sleeperov/shmel-ok/docs/user.md

# Hall of fame

This page contains user-built drones based on the Flix project. Publish your projects into the official Telegram-chat: [@opensourcequadcopterchat](https://t.me/opensourcequadcopterchat) or send materials as a pull request.

---

Author: [@fisheyeu](https://t.me/fisheyeu).<br>
[Video](https://drive.google.com/file/d/1IT4eMmWPZpmaZR_qsIRmNJ52hYkFB_0q/view?usp=share_link).

<table>
	<tr>
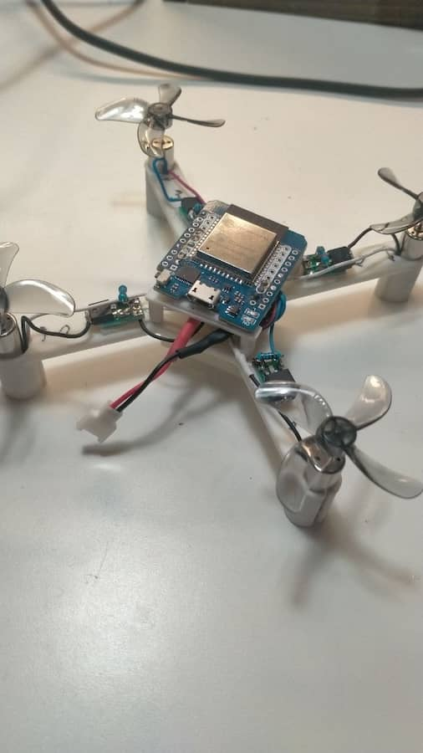
[picture p5: docs/img/user/fisheyeu/1.jpg]
		<td></td>
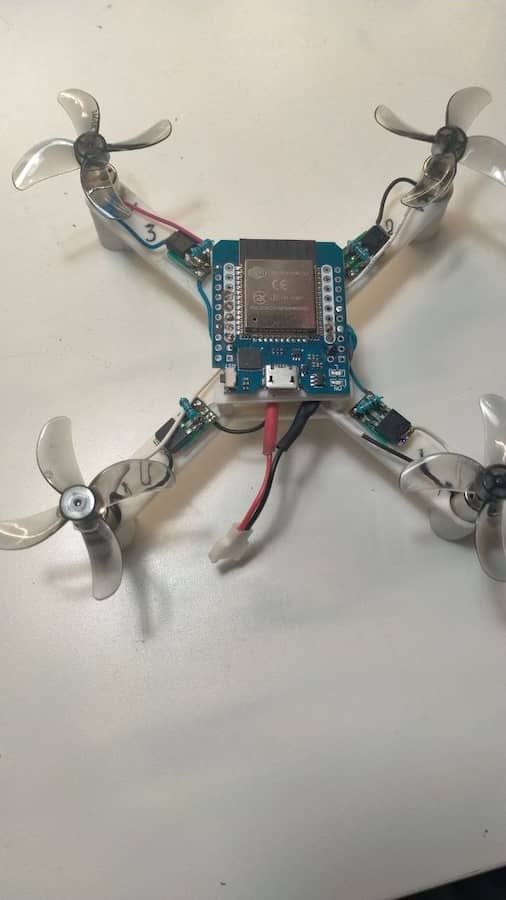
[picture p6: docs/img/user/fisheyeu/2.jpg]
		<td></td>
	</tr>
</table>

---

Author: [@p_kabakov](https://t.me/p_kabakov).<br>
Custom propellers guard 3D-model: https://drive.google.com/file/d/1TKnzwvrZYzYuRTLLERNmnKH71H9n4Xj_/view?usp=share_link.<br>
Features: ESP32-C3 microcontroller is used.<br>
[Video](https://drive.google.com/file/d/1B0NMcsk0fgwUgNr9XuLOdR2yYCuaj008/view?usp=share_link).

<table>
	<tr>
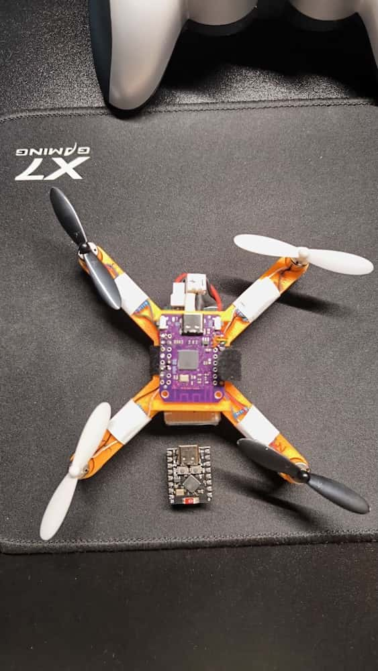
[picture p7: docs/img/user/p_kabakov/1.jpg]
		<td></td>
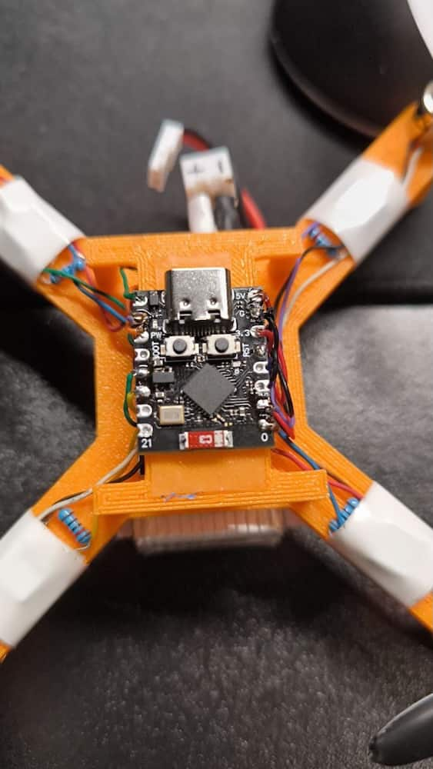
[picture p8: docs/img/user/p_kabakov/2.jpg]
		<td></td>
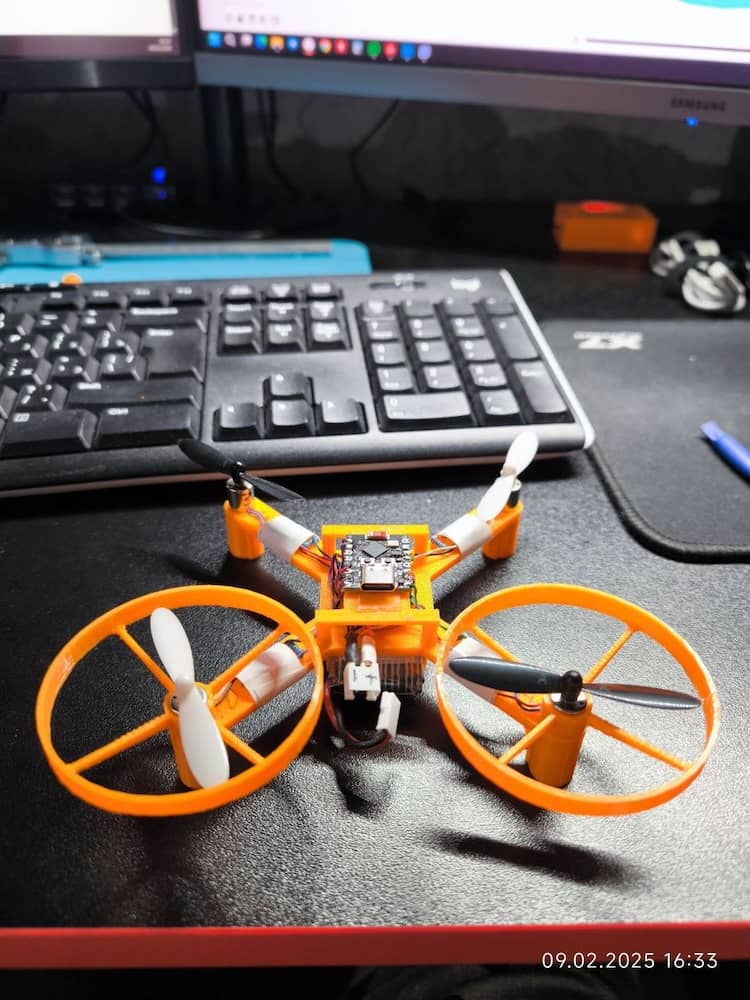
[picture p9: docs/img/user/p_kabakov/3.jpg]
		<td></td>
	</tr>
</table>

---

Author: [@yi_lun](https://t.me/yi_lun).<br>
[Video](https://drive.google.com/file/d/1TkSuvHQ_0qQPFUpY5XjJzmhnpX_07cTg/view?usp=share_link).

<table>
	<tr>
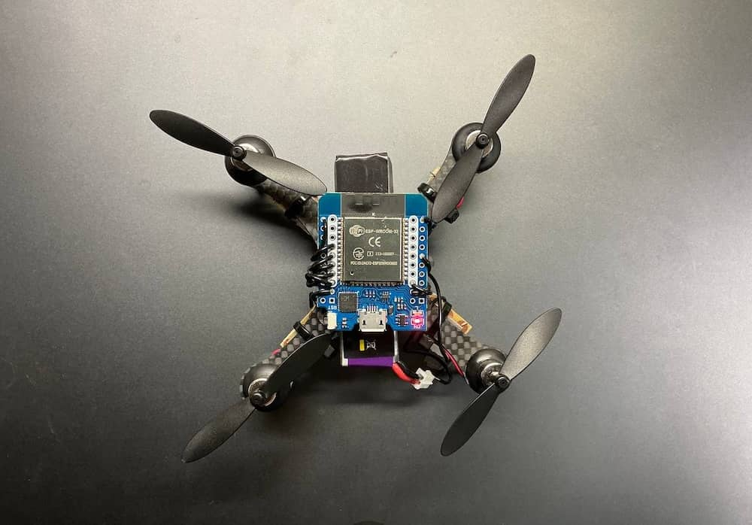
[picture p10: docs/img/user/yi_lun/1.jpg]
		<td></td>
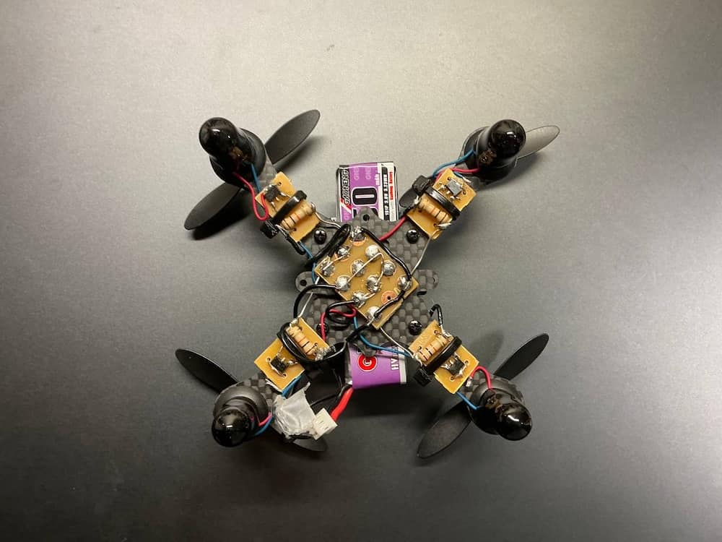
[picture p11: docs/img/user/yi_lun/2.jpg]
		<td></td>
	</tr>
</table>

---

Author: [@peter_ukhov](https://t.me/peter_ukhov).<br>
Features: customized ESP32 holder, GY-ICM20948V2 IMU board, boost-converter for powering the ESP32.<br>
Files for 3D-printing: https://drive.google.com/file/d/1Sma-FEzFBj2HA5ixJtUyH0uWixvr6vdK/view?usp=share_link.<br>
Schematics: https://miro.com/app/board/uXjVN-dTjoo=/?moveToWidget=3458764612179508274&cot=14.<br>

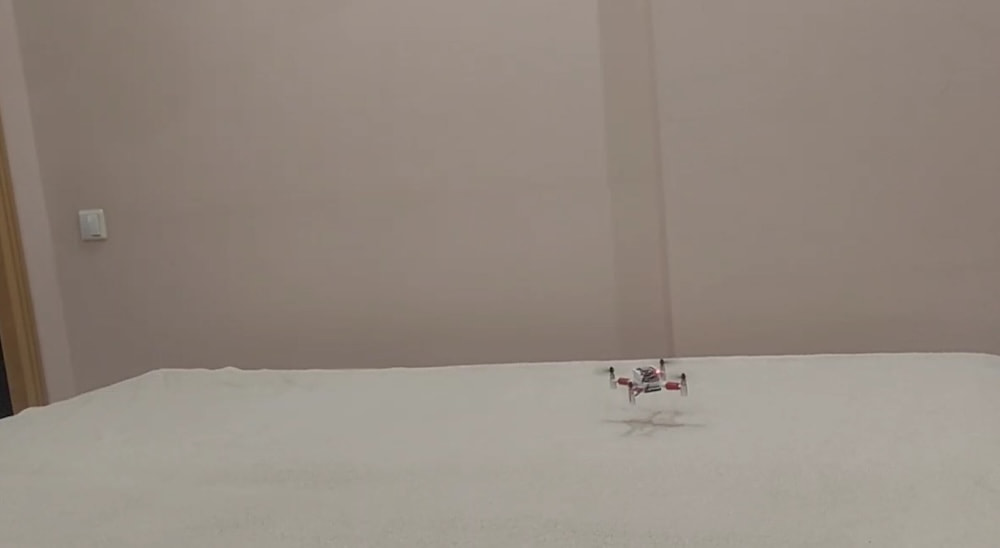
[picture p12: docs/img/user/peter_ukhov-2/video.jpg]


<table>
	<tr>
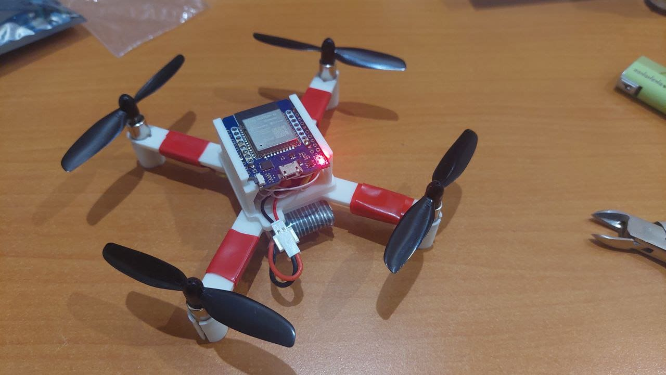
[picture p13: docs/img/user/peter_ukhov-2/1.jpg]
		<td></td>
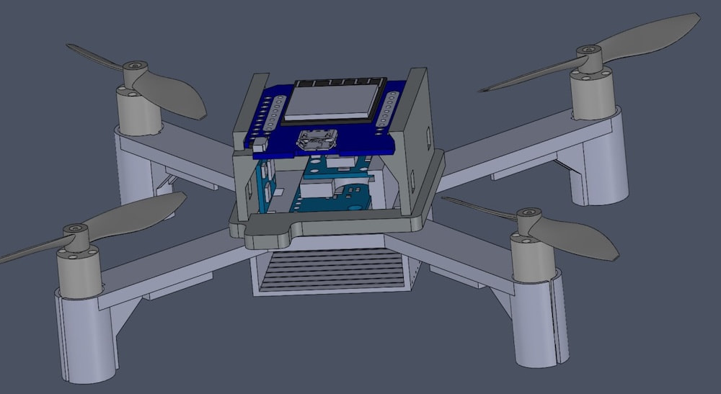
[picture p14: docs/img/user/peter_ukhov-2/2.jpg]
		<td></td>
	</tr>
</table>

---

Author: [@Alexey_Karakash](https://t.me/Alexey_Karakash).<br>
Files for 3D printing of the custom frame: https://drive.google.com/file/d/1tkNmujrHrKpTMVtsRH3mor2zdAM0JHum/view?usp=share_link.<br>

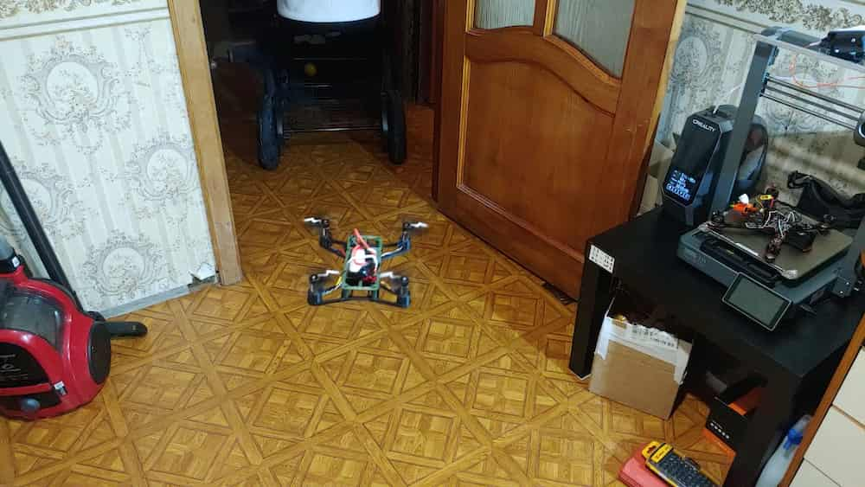
[picture p15: docs/img/user/alexey_karakash/video.jpg]


<table>
	<tr>
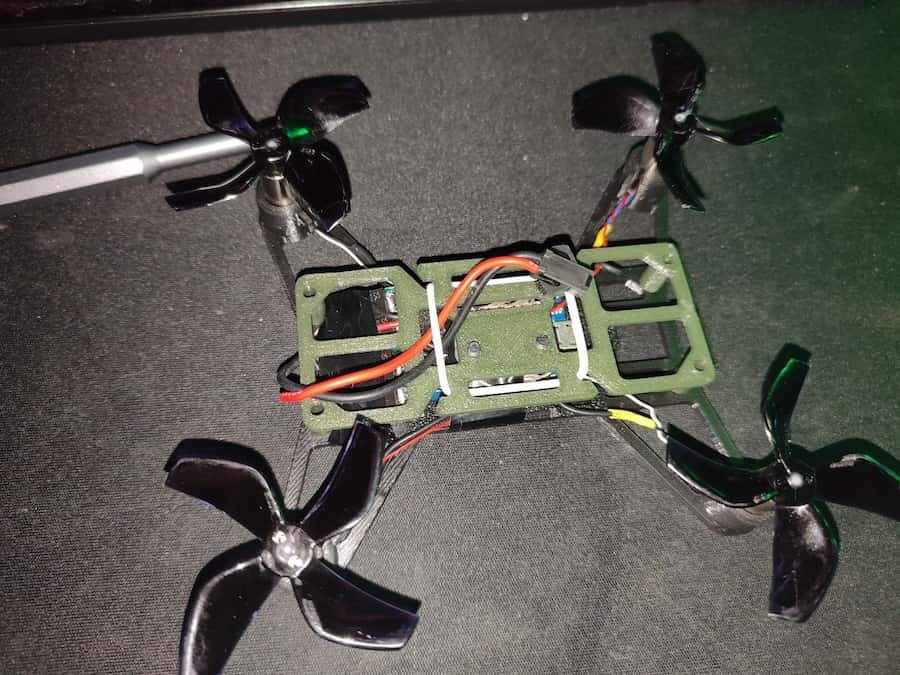
[picture p16: docs/img/user/alexey_karakash/1.jpg]
		<td></td>
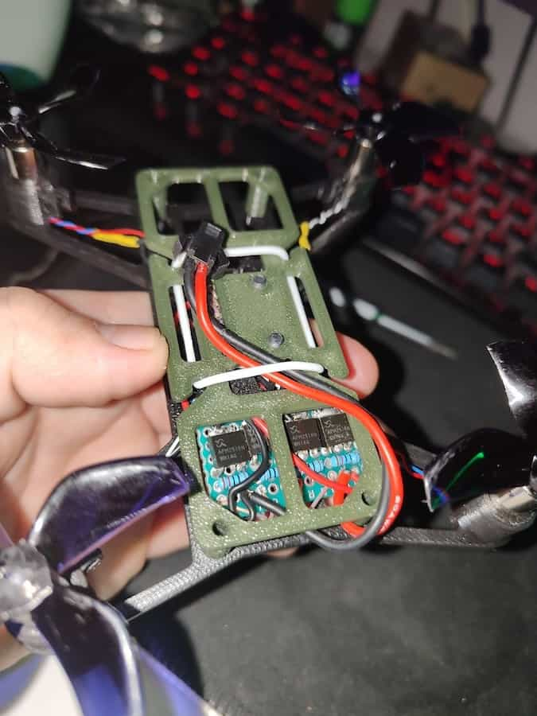
[picture p17: docs/img/user/alexey_karakash/2.jpg]
		<td></td>
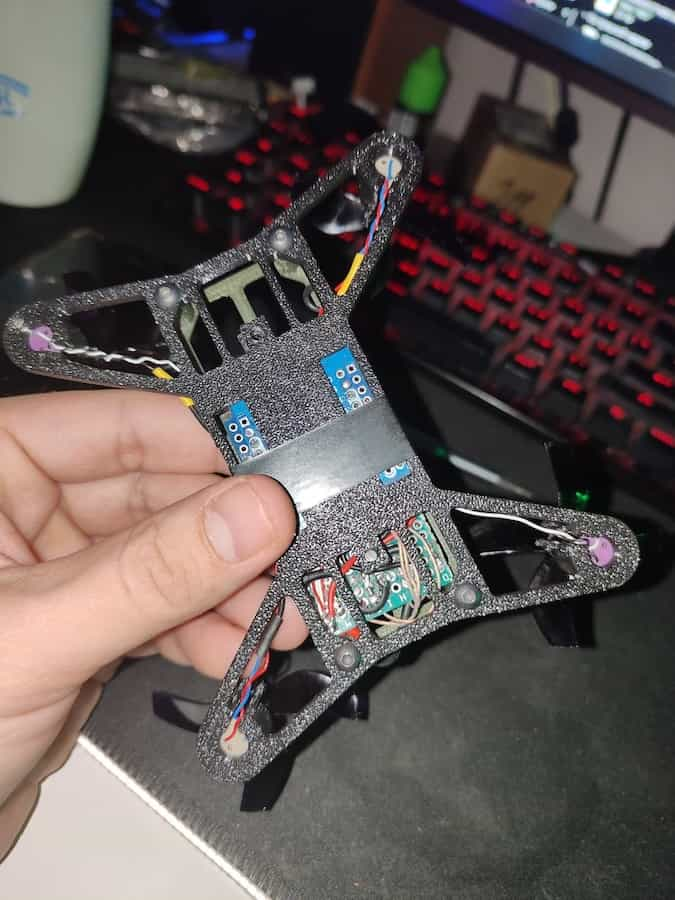
[picture p18: docs/img/user/alexey_karakash/3.jpg]
		<td></td>
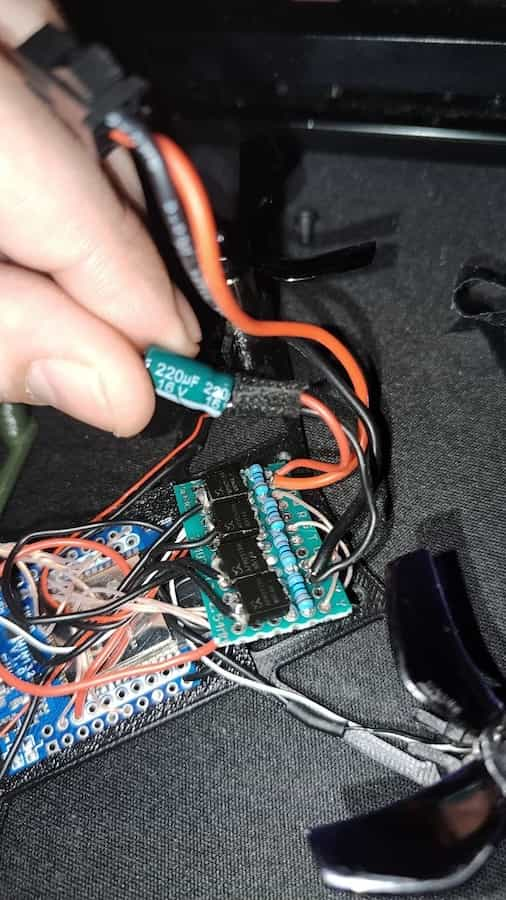
[picture p19: docs/img/user/alexey_karakash/4.jpg]
		<td></td>
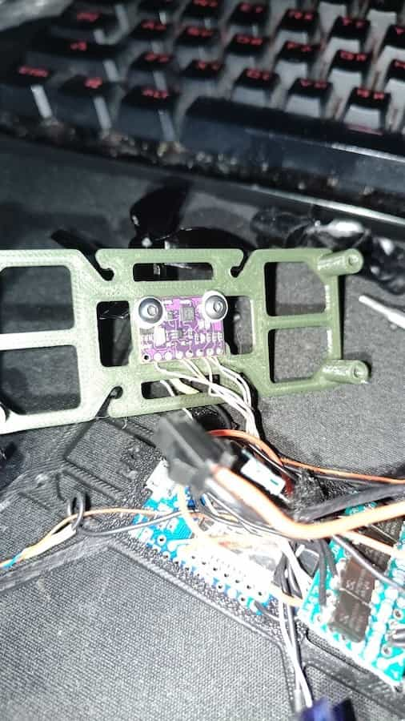
[picture p20: docs/img/user/alexey_karakash/5.jpg]
		<td></td>
	</tr>
</table>

---

Author: [@rudpa](https://t.me/rudpa).<br>

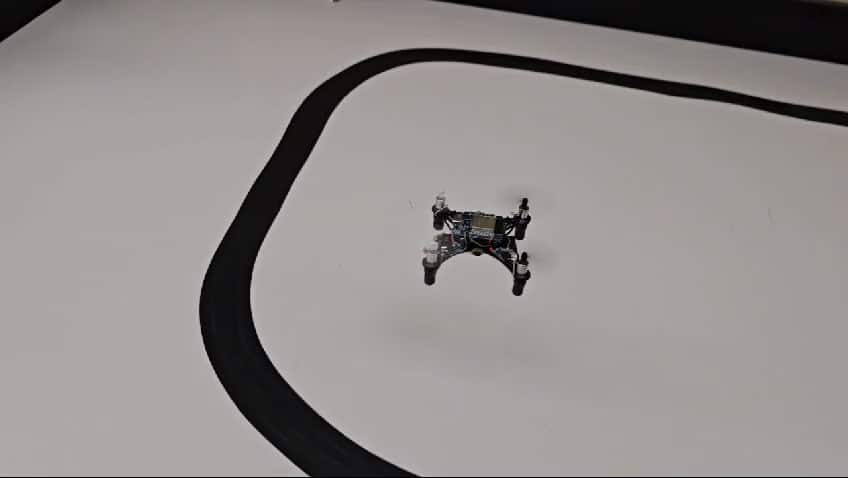
[picture p21: docs/img/user/rudpa/video.jpg]


<table>
	<tr>
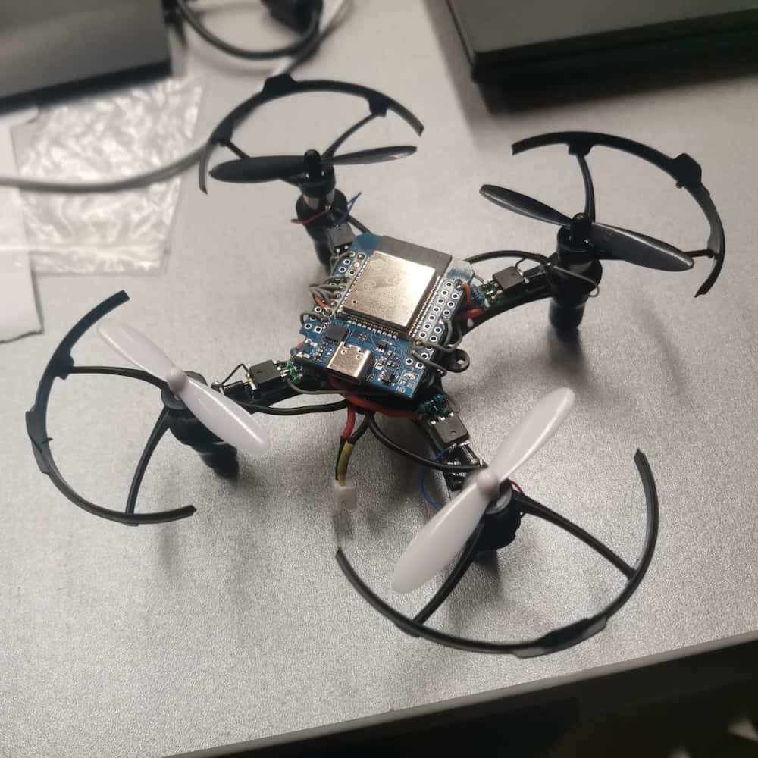
[picture p22: docs/img/user/rudpa/1.jpg]
		<td></td>
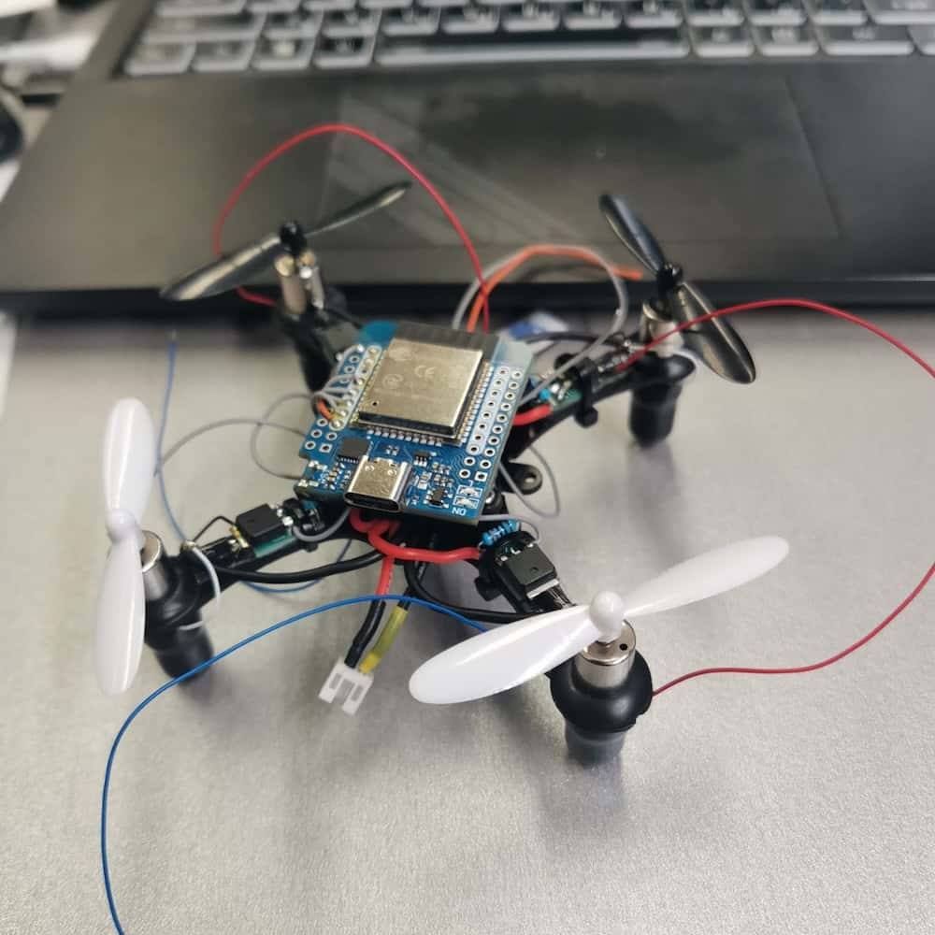
[picture p23: docs/img/user/rudpa/2.jpg]
		<td></td>
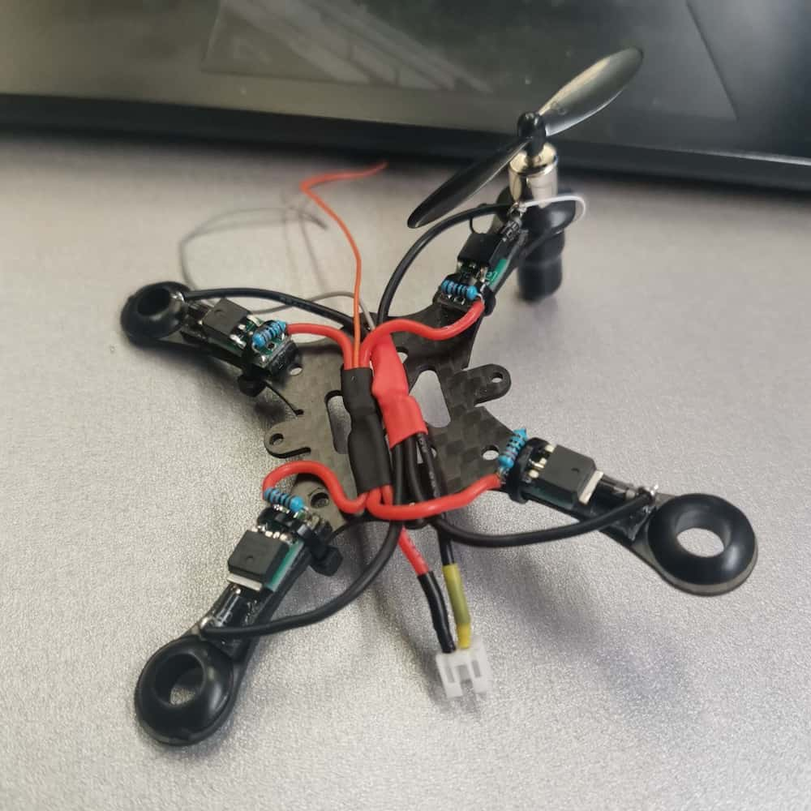
[picture p24: docs/img/user/rudpa/3.jpg]
		<td></td>
	</tr>
</table>

---

Author: [@peter_ukhov](https://t.me/peter_ukhov).<br>
Schematics: https://miro.com/app/board/uXjVN-dTjoo=/?moveToWidget=3458764612338222067&cot=14.<br>

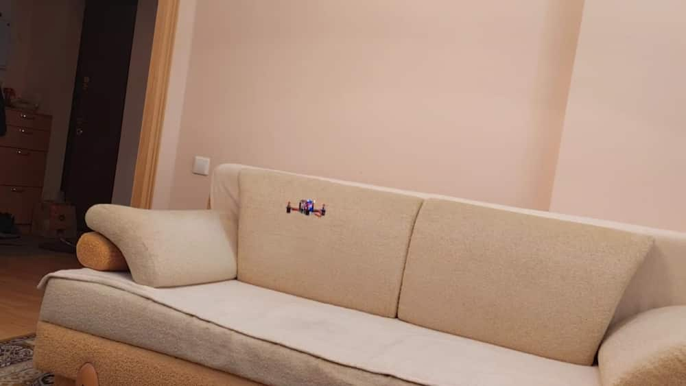
[picture p25: docs/img/user/peter_ukhov/video.jpg]


<table>
	<tr>
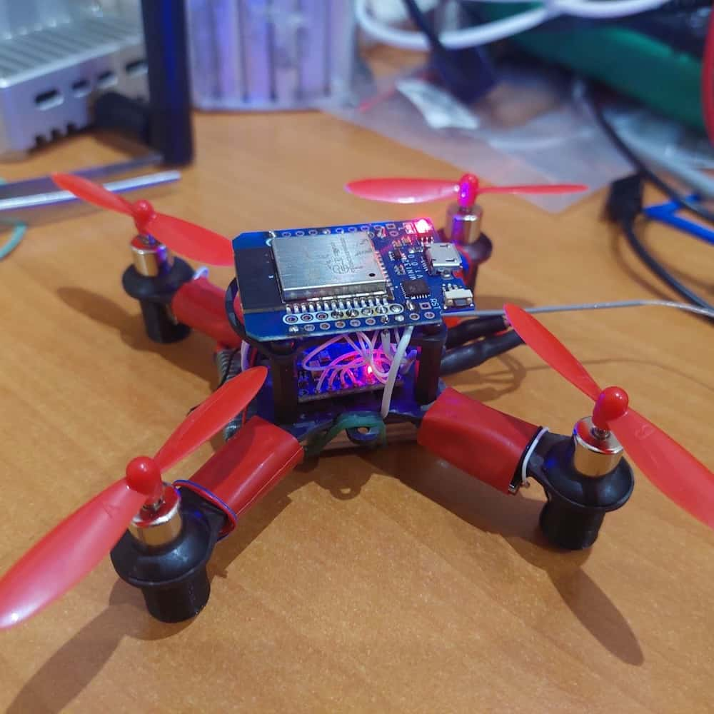
[picture p26: docs/img/user/peter_ukhov/1.jpg]
		<td></td>
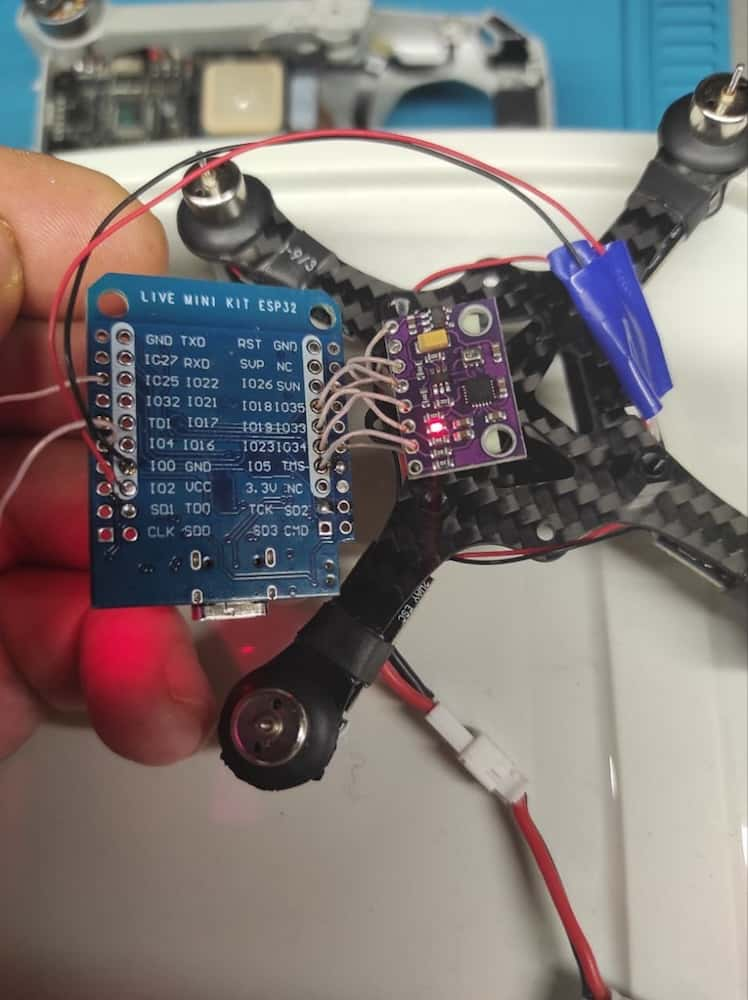
[picture p27: docs/img/user/peter_ukhov/2.jpg]
		<td></td>
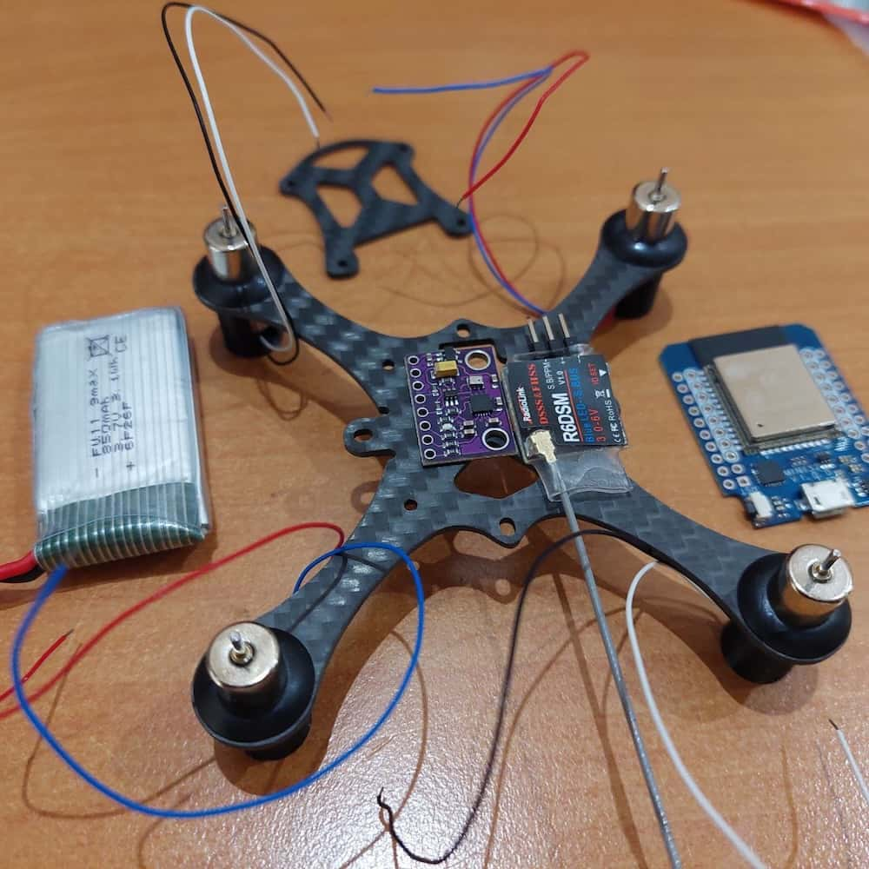
[picture p28: docs/img/user/peter_ukhov/3.jpg]
		<td></td>
	</tr>
</table>
