sleeperov/shmel-ok/docs/version0.md

# Flix version 0

Flix version 0 (obsolete):

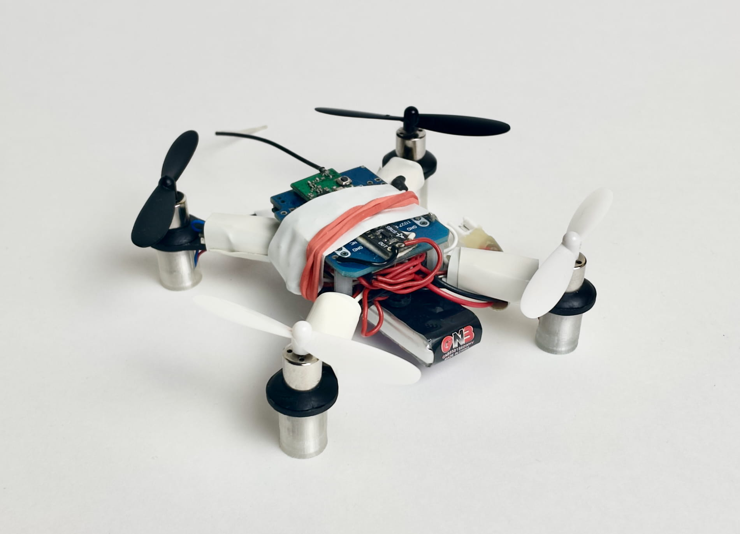
[picture p29: docs/img/flix.jpg]
Flix quadcopter


## Components list

|Type|Part|Image|Quantity|
|-|-|-|-|
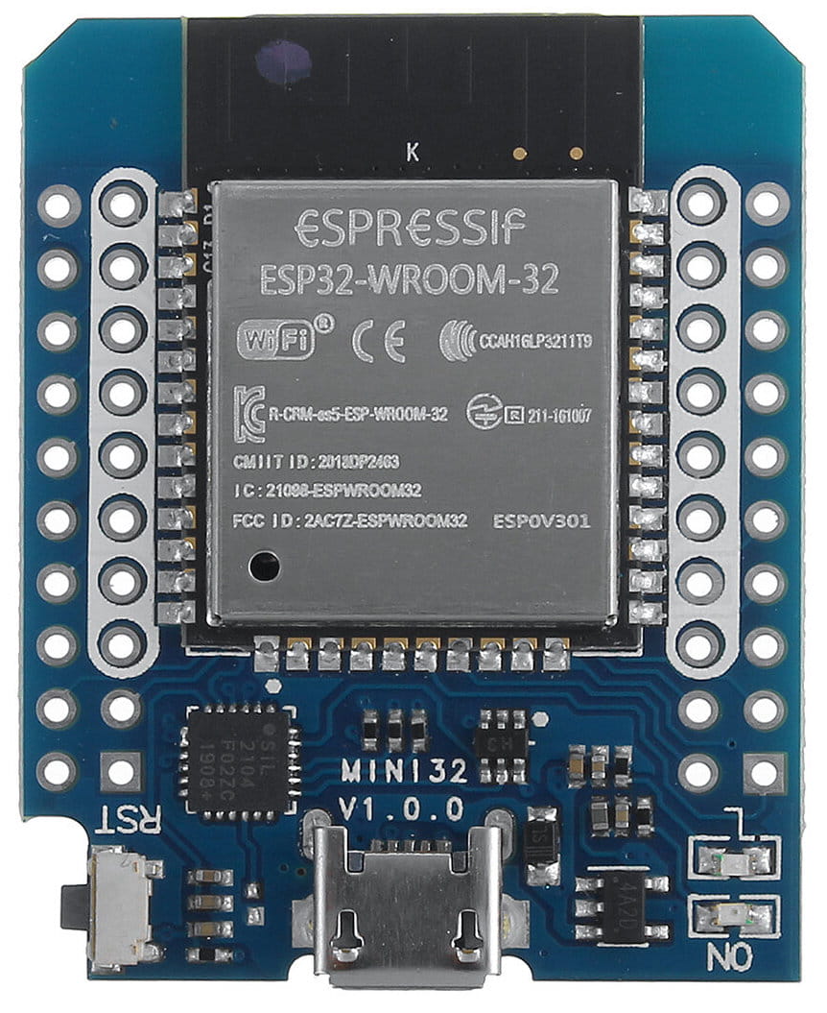
[picture p30: docs/img/esp32.jpg]
|Microcontroller board|ESP32 Mini||1|
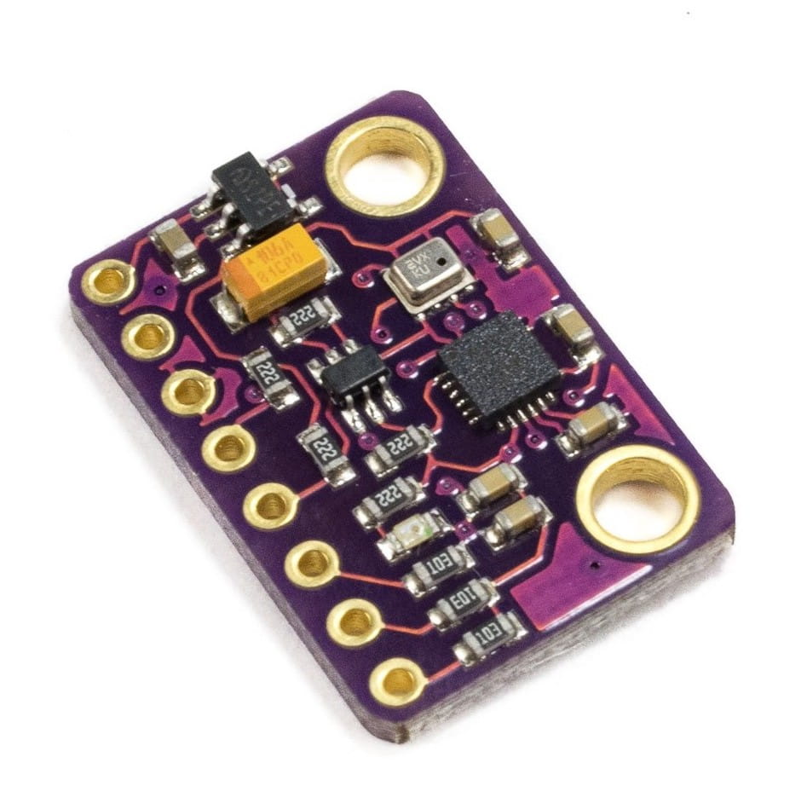
[picture p31: docs/img/gy-91.jpg]
|IMU and barometer² board|GY-91 (or other MPU-9250 board)||1|
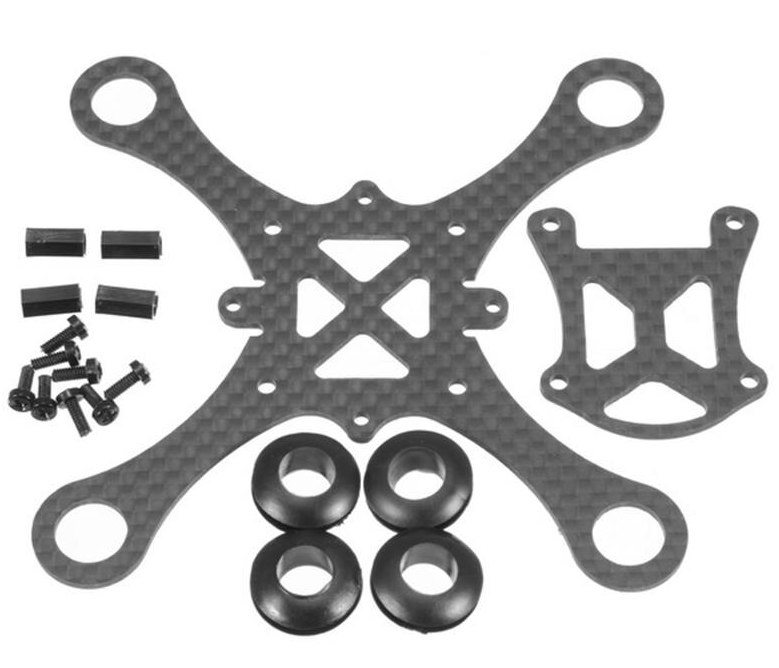
[picture p32: docs/img/frame.jpg]
|Quadcopter frame|K100||1|
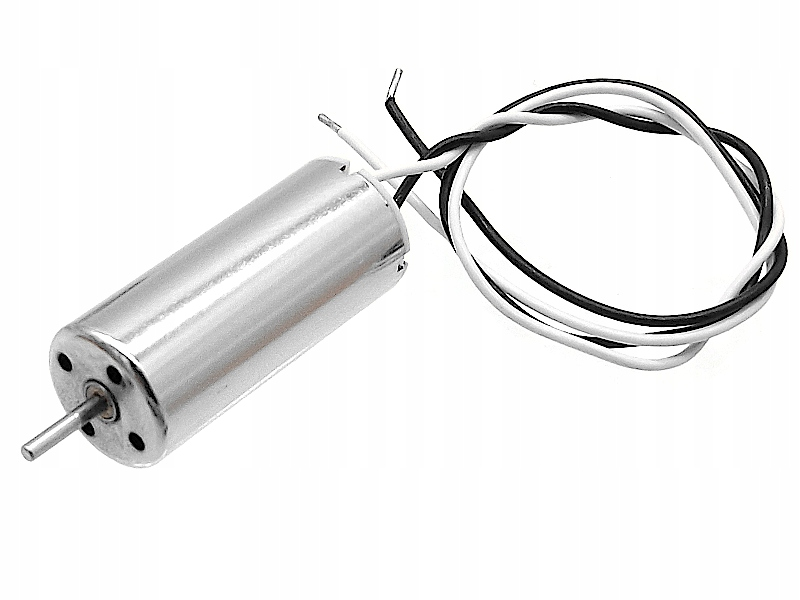
[picture p33: docs/img/motor.jpeg]
|Motor|8520 3.7V brushed motor (**shaft 0.8mm!**)||4|
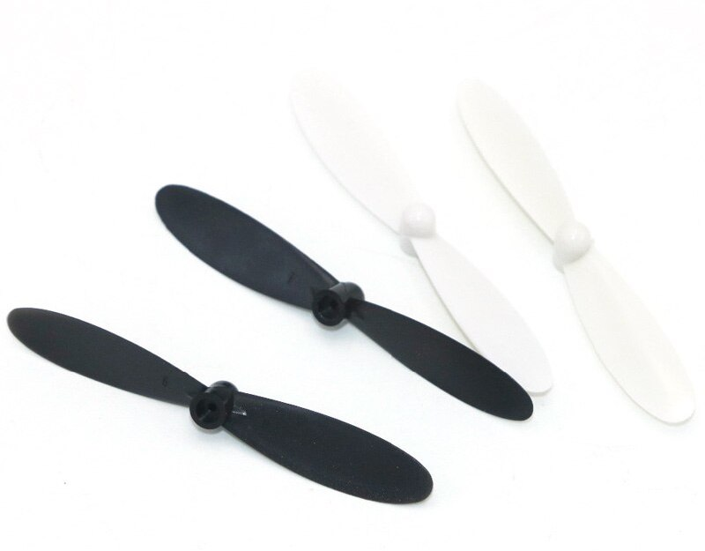
[picture p34: docs/img/prop.jpg]
|Propeller|Hubsan 55 mm||4|
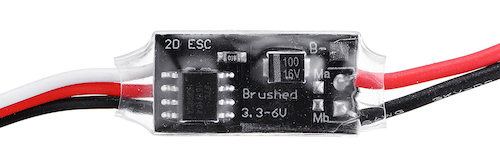
[picture p35: docs/img/esc.jpg]
|Motor ESC|2.7A 1S Dual Way Micro Brush ESC||4|
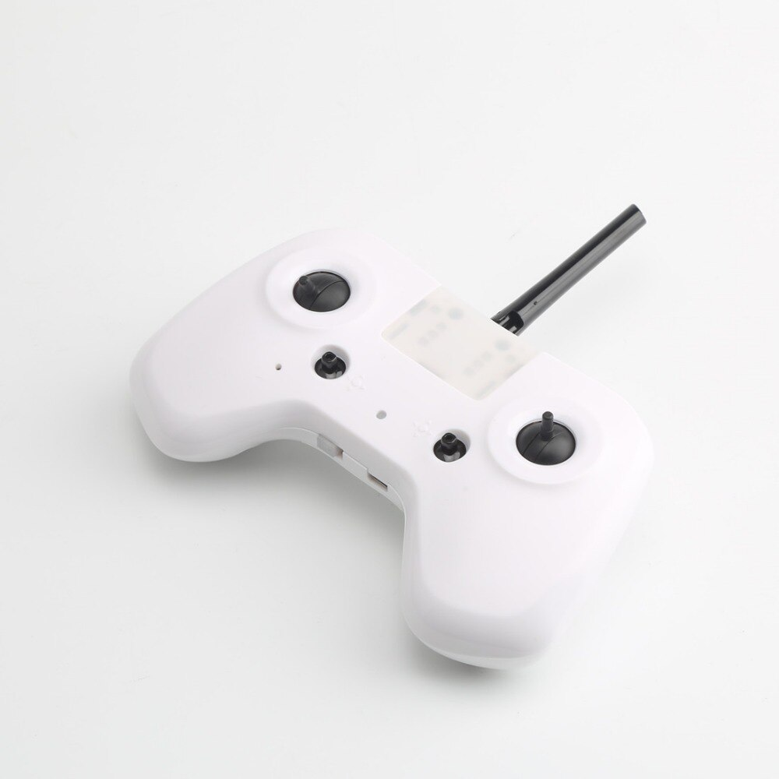
[picture p36: docs/img/tx.jpg]
|RC transmitter|KINGKONG TINY X8||1|
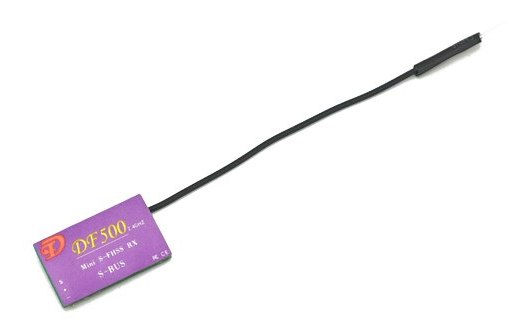
[picture p37: docs/img/rx.jpg]
|RC receiver|DF500 (SBUS)||1|
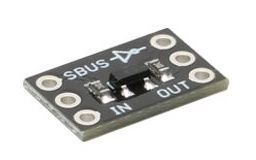
[picture p38: docs/img/inv.jpg]
|~~SBUS inverter~~*|||~~1~~|
|Battery|3.7 Li-Po 850 MaH 60C|||
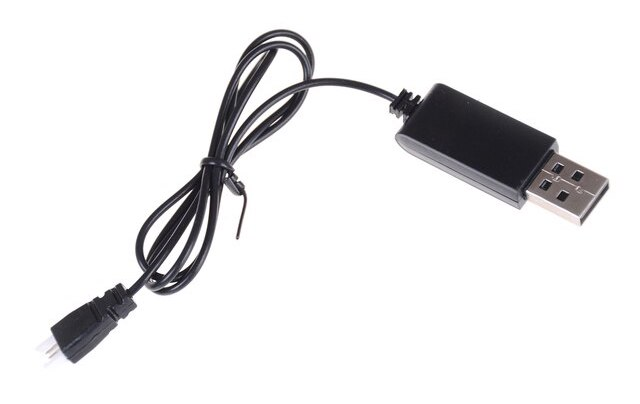
[picture p39: docs/img/charger.jpg]
|Battery charger|||1|
|Wires, connectors, tape, ...||||

*\* — not needed as ESP32 supports [software pin inversion](https://github.com/bolderflight/sbus#inverted-serial).*

## Schematics

Flix schematics

You can also check a user contributed [variant of complete circuit diagram](https://miro.com/app/board/uXjVN-dTjoo=/?moveToWidget=3458764574482511443&cot=14) of the drone.
