sleeperov/shmel-ok/docs/book/SUMMARY.md

<!-- markdownlint-disable MD041 -->
<!-- markdownlint-disable MD042 -->

[Главная](./README.md)

* [Архитектура прошивки](firmware.md)

# Учебник

* [Основы]()
* [Светодиод]()
* [Моторы]()
* [Радиоуправление]()
* [Гироскоп](gyro.md)
* [Акселерометр]()
* [Оценка состояния]()
* [PID-регулятор]()
* [Режим ACRO]()
* [Режим STAB]()
* [Wi-Fi]()
* [MAVLink]()
* [Симуляция]()
