sleeperov/shmel-ok/docs/book/README.md

# Flix

> [!IMPORTANT]
> Flix — это проект по созданию открытого квадрокоптера на базе ESP32 с нуля и учебника по разработке полетных контроллеров.

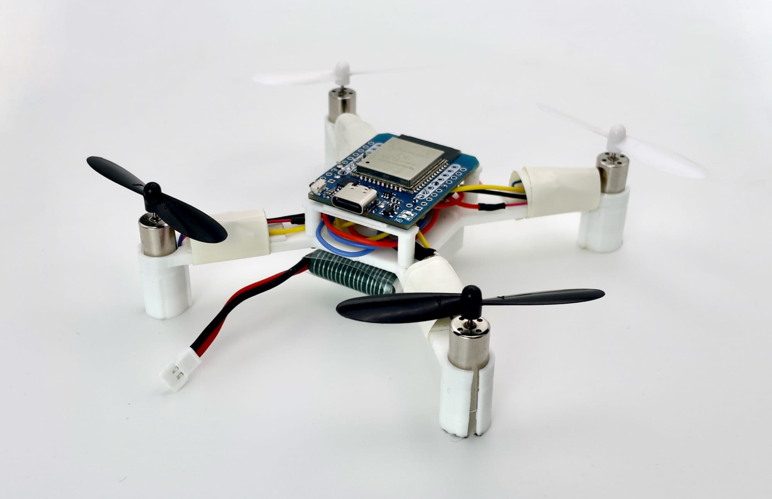
[picture p46: docs/img/flix1.jpg]
Flix quadcopter


<p class="github">GitHub:&nbsp;<a href="https://github.com/okalachev/flix">github.com/okalachev/flix</a>.</p>

<p class="telegram">Telegram-канал:&nbsp;<a href="https://t.me/opensourcequadcopter">@opensourcequadcopter</a>.</p>
