sleeperov/shmel-ok/gazebo/models/flix/flix.stl

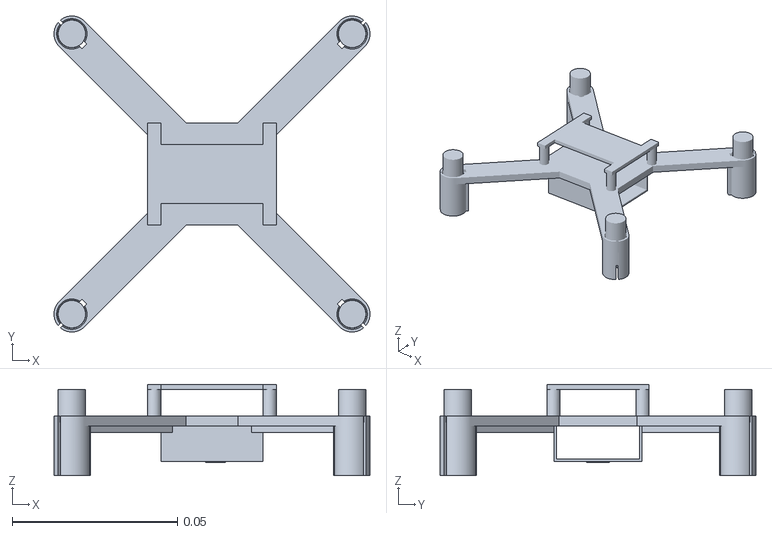
[picture p110: CAD file, 2025-02-17]
gazebo/models/flix/flix.stl
0.0957 x 0.0957 x 0.0276
