sleeperov/shmel-ok/shmel-ok-frame.stl

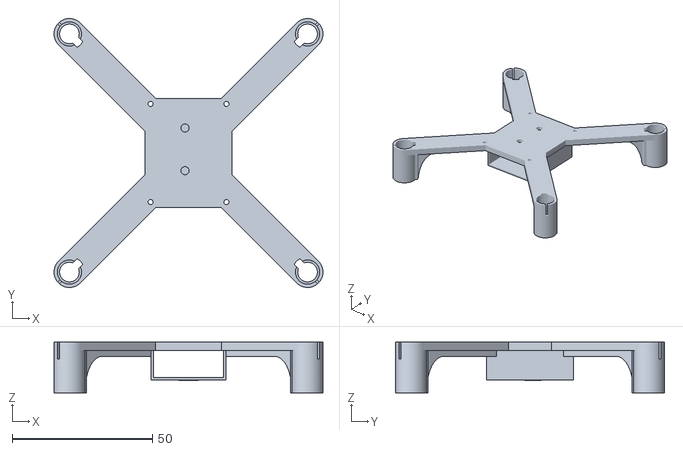
[picture p111: CAD file, 2025-02-17]
shmel-ok-frame.stl
95.9 x 95.9 x 18.0
