sleeperov/shmel-ok/docs/assets/esp32-holder.step

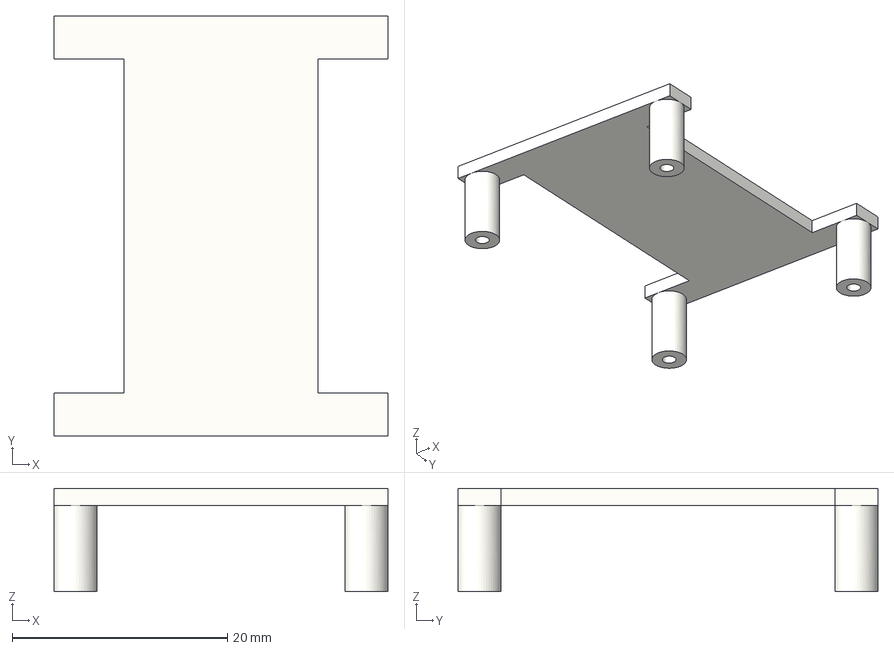
[picture p112: CAD file, 2025-02-17]
docs/assets/esp32-holder.step
31.0 x 39.0 x 9.60 mm
