sleeperov/shmel-ok/shmel-ok-GY-91.stl

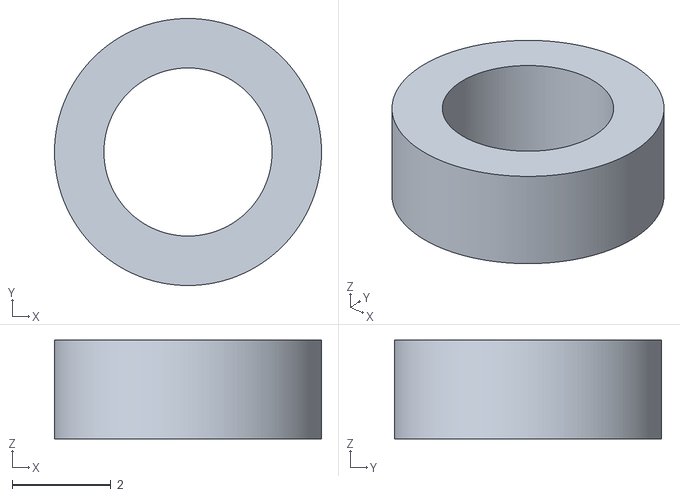
[picture p113: CAD file, 2025-02-17]
shmel-ok-GY-91.stl
5.40 x 5.40 x 2.00
