sleeperov/shmel-ok/(list of files, cad)

Other CAD files:
docs/assets/flix-frame.step
shmel-ok-esp32.stl
docs/assets/flix-frame-1.1.step
docs/assets/washer-m3.step
docs/assets/flix-frame.stl
