sleeperov/shmel-ok/docs/assembly.md

# Brief assembly guide

Soldered components ([schematics variant](https://miro.com/app/board/uXjVN-dTjoo=/?moveToWidget=3458764612338222067&cot=14)):

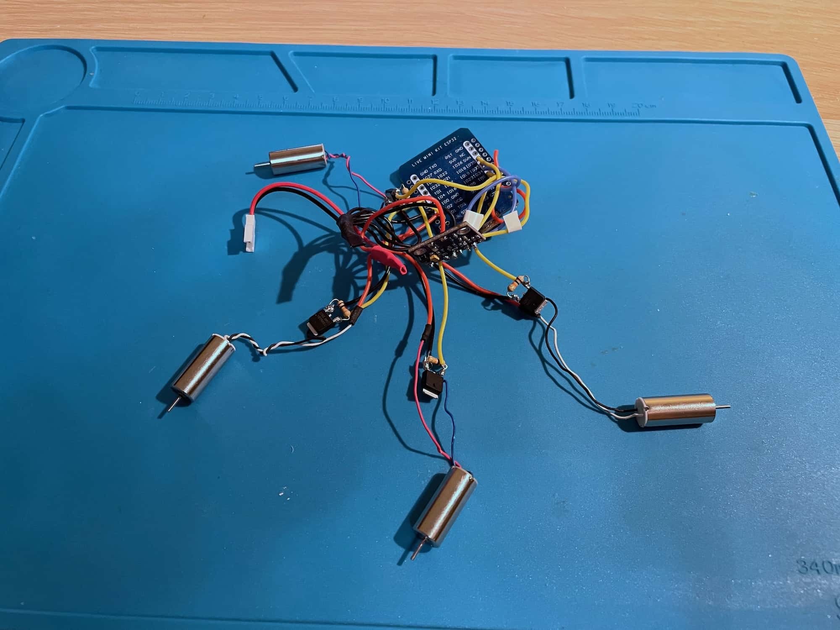
[picture p114: docs/img/assembly/1.jpg]


<br>Use double-sided tape to attach ESP32 to the top frame part (ESP32 holder):

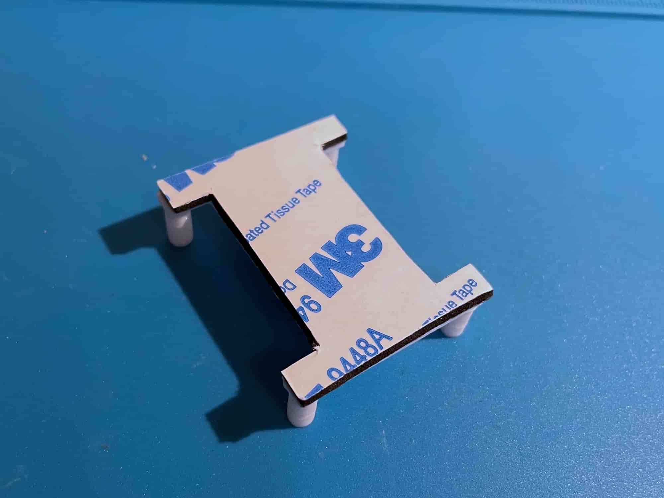
[picture p115: docs/img/assembly/2.jpg]


<br>Use two washers to screw the IMU board to the frame:

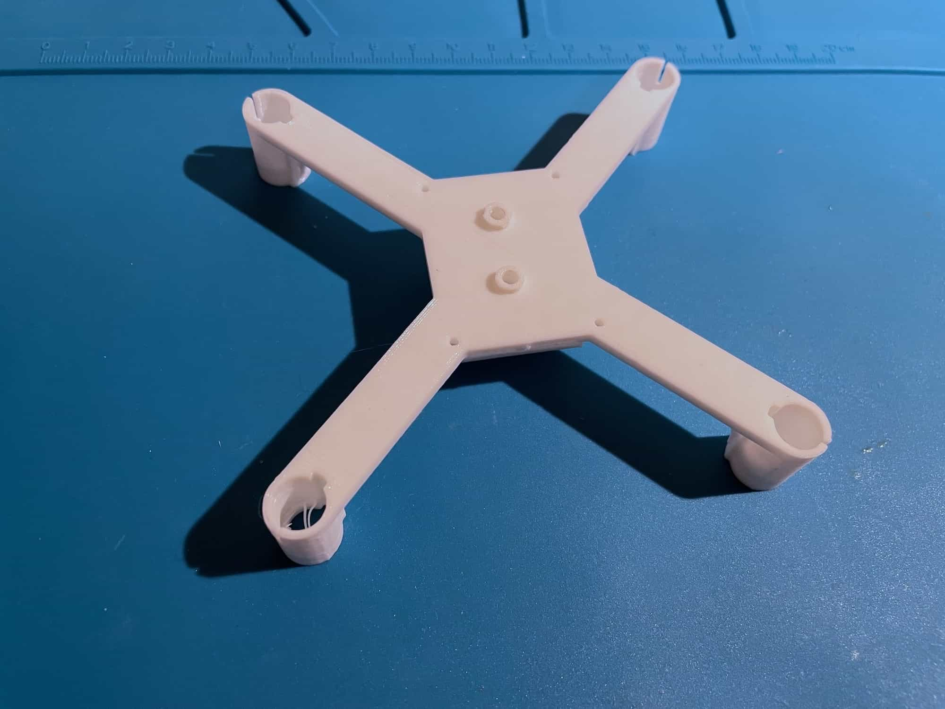
[picture p116: docs/img/assembly/3.jpg]


<br>Screw the IMU with M3x5 screws as shown:

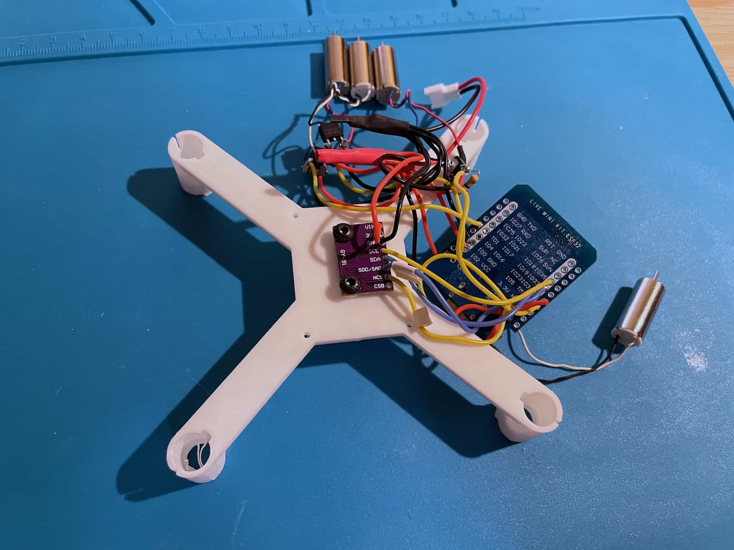
[picture p117: docs/img/assembly/4.jpg]


<br>Install the motors, attach MOSFETs to the frame using tape:

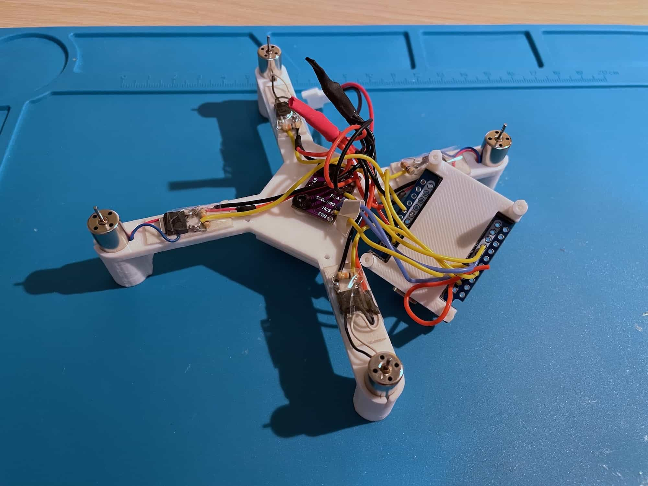
[picture p118: docs/img/assembly/5.jpg]


<br>Screw the ESP32 holder with M1.4x5 screws to the frame:

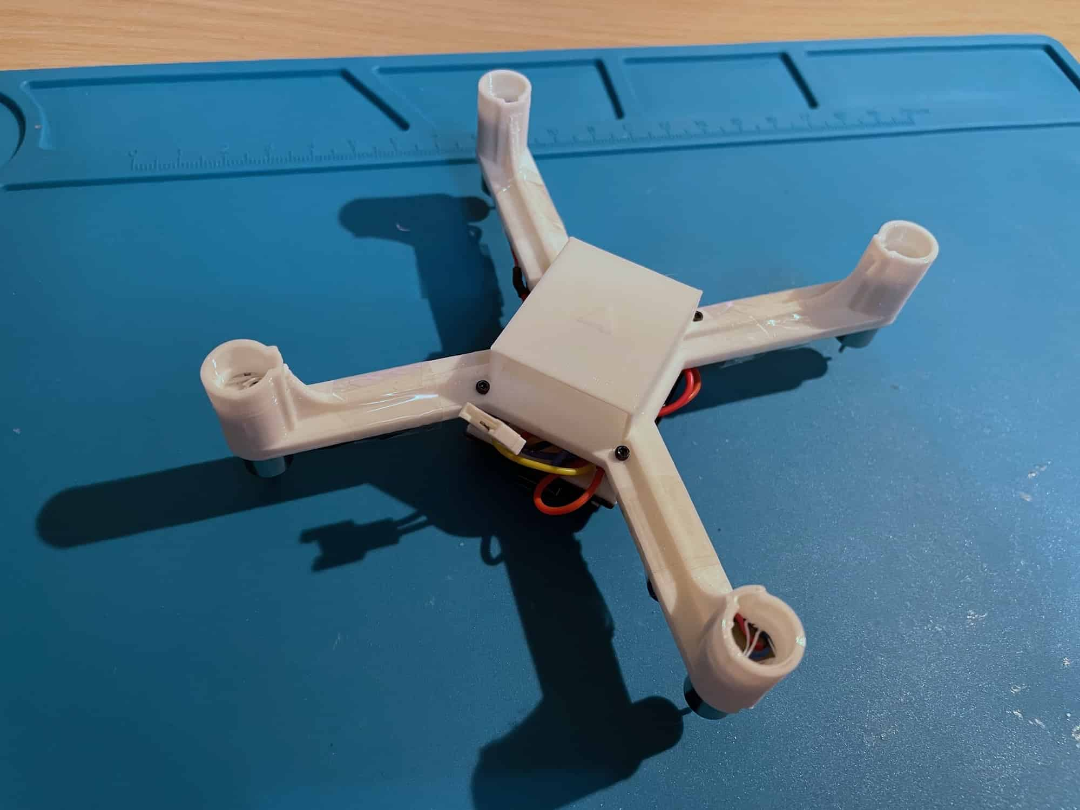
[picture p119: docs/img/assembly/6.jpg]


<br>Assembled drone:

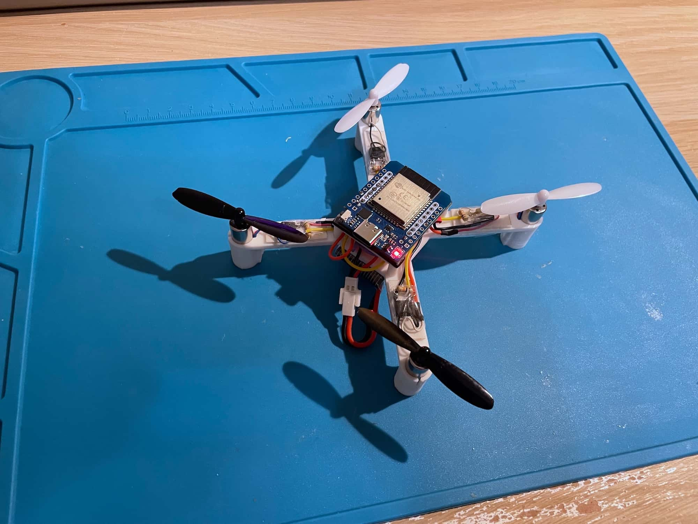
[picture p120: docs/img/assembly/7.jpg]
