sleeperov/shmel-ok/shmel-ok/motors.ino

// Motors output control using MOSFETs
// In case of using ESCs, change PWM_STOP, PWM_MIN and PWM_MAX to appropriate values in μs, decrease PWM_FREQUENCY (to 400)

#include "util.h"

#define MOTOR_0_PIN 12 // rear left
#define MOTOR_1_PIN 13 // rear right
#define MOTOR_2_PIN 14 // front right
#define MOTOR_3_PIN 15 // front left

#define PWM_FREQUENCY 1000
#define PWM_RESOLUTION 12
#define PWM_STOP 0
#define PWM_MIN 0
#define PWM_MAX 1000000 / PWM_FREQUENCY

// Motors array indexes:
const int MOTOR_REAR_LEFT = 0;
const int MOTOR_REAR_RIGHT = 1;
const int MOTOR_FRONT_RIGHT = 2;
const int MOTOR_FRONT_LEFT = 3;

void setupMotors() {
	Serial.println("Setup Motors");

	// configure pins
	ledcAttach(MOTOR_0_PIN, PWM_FREQUENCY, PWM_RESOLUTION);
	ledcAttach(MOTOR_1_PIN, PWM_FREQUENCY, PWM_RESOLUTION);
	ledcAttach(MOTOR_2_PIN, PWM_FREQUENCY, PWM_RESOLUTION);
	ledcAttach(MOTOR_3_PIN, PWM_FREQUENCY, PWM_RESOLUTION);

	sendMotors();
	Serial.println("Motors initialized");
}

int getDutyCycle(float value) {
	value = constrain(value, 0, 1);
	float pwm = mapff(value, 0, 1, PWM_MIN, PWM_MAX);
	if (value == 0) pwm = PWM_STOP;
	float duty = mapff(pwm, 0, 1000000 / PWM_FREQUENCY, 0, (1 << PWM_RESOLUTION) - 1);
	return round(duty);
}

void sendMotors() {
	ledcWrite(MOTOR_0_PIN, getDutyCycle(motors[0]));
	ledcWrite(MOTOR_1_PIN, getDutyCycle(motors[1]));
	ledcWrite(MOTOR_2_PIN, getDutyCycle(motors[2]));
	ledcWrite(MOTOR_3_PIN, getDutyCycle(motors[3]));
}

bool motorsActive() {
	return motors[0] != 0 || motors[1] != 0 || motors[2] != 0 || motors[3] != 0;
}
