sleeperov/shmel-ok/shmel-ok/cli.ino

#include "pid.h"
#include "vector.h"

extern const int MOTOR_REAR_LEFT, MOTOR_REAR_RIGHT, MOTOR_FRONT_RIGHT, MOTOR_FRONT_LEFT;
extern float loopRate, dt;
extern double t;
extern int rollChannel, pitchChannel, throttleChannel, yawChannel, armedChannel, modeChannel;
"Commands:\n\n"
"help - show help\n"
"p - show all parameters\n"
"p <name> - show parameter\n"
"p <name> <value> - set parameter\n"
"preset - reset parameters\n"
"time - show time info\n"
"ps - show pitch/roll/yaw\n"
"psq - show attitude quaternion\n"
"imu - show IMU data\n"
"rc - show RC data\n"
"mot - show motor output\n"
"log - dump in-RAM log\n"
"cr - calibrate RC\n"
"cg - calibrate gyro\n"
"ca - calibrate accel\n"
"mfr, mfl, mrr, mrl - test motor (remove props)\n"
"reset - reset drone's state\n"
"reboot - reboot the drone\n";

void doCommand(const String& command, const String& arg0, const String& arg1) {
	if (command == "help" || command == "motd") {
		Serial.println(motd);
	} else if (command == "p" && arg0 == "") {
		printParameters();
	} else if (command == "p" && arg0 != "" && arg1 == "") {
		Serial.printf("%s = %g\n", arg0.c_str(), getParameter(arg0.c_str()));
	} else if (command == "p") {
		bool success = setParameter(arg0.c_str(), arg1.toFloat());
		if (success) {
			Serial.printf("%s = %g\n", arg0.c_str(), arg1.toFloat());
		} else {
			Serial.printf("Parameter not found: %s\n", arg0.c_str());
		}
	} else if (command == "preset") {
		resetParameters();
	} else if (command == "time") {
		Serial.printf("Time: %f\n", t);
		Serial.printf("Loop rate: %f\n", loopRate);
		Serial.printf("dt: %f\n", dt);
	} else if (command == "ps") {
		Vector a = attitude.toEulerZYX();
		Serial.printf("roll: %f pitch: %f yaw: %f\n", degrees(a.x), degrees(a.y), degrees(a.z));
	} else if (command == "psq") {
		Serial.printf("qx: %f qy: %f qz: %f qw: %f\n", attitude.x, attitude.y, attitude.z, attitude.w);
	} else if (command == "imu") {
		printIMUInfo();
		Serial.printf("gyro: %f %f %f\n", rates.x, rates.y, rates.z);
		Serial.printf("acc: %f %f %f\n", acc.x, acc.y, acc.z);
		printIMUCal();
		Serial.printf("rate: %f\n", loopRate);
	} else if (command == "rc") {
		Serial.printf("Raw: throttle %d yaw %d pitch %d roll %d armed %d mode %d\n",
			channels[throttleChannel], channels[yawChannel], channels[pitchChannel],
			channels[rollChannel], channels[armedChannel], channels[modeChannel]);
		Serial.printf("Control: throttle %g yaw %g pitch %g roll %g armed %g mode %g\n",
			controls[throttleChannel], controls[yawChannel], controls[pitchChannel],
			controls[rollChannel], controls[armedChannel], controls[modeChannel]);
		Serial.printf("Mode: %s\n", getModeName());
	} else if (command == "mot") {
		Serial.printf("Motors: front-right %g front-left %g rear-right %g rear-left %g\n",
			motors[MOTOR_FRONT_RIGHT], motors[MOTOR_FRONT_LEFT], motors[MOTOR_REAR_RIGHT], motors[MOTOR_REAR_LEFT]);
	} else if (command == "log") {
		dumpLog();
	} else if (command == "cr") {
		calibrateRC();
	} else if (command == "cg") {
		calibrateGyro();
	} else if (command == "ca") {
		calibrateAccel();
	} else if (command == "mfr") {
		cliTestMotor(MOTOR_FRONT_RIGHT);
	} else if (command == "mfl") {
		cliTestMotor(MOTOR_FRONT_LEFT);
	} else if (command == "mrr") {
		cliTestMotor(MOTOR_REAR_RIGHT);
	} else if (command == "mrl") {
		cliTestMotor(MOTOR_REAR_LEFT);
	} else if (command == "reset") {
		attitude = Quaternion();
	} else if (command == "reboot") {
		ESP.restart();
	} else if (command == "") {
		// do nothing
	} else {
		Serial.println("Invalid command: " + command);
	}
}

void cliTestMotor(uint8_t n) {
	Serial.printf("Testing motor %d\n", n);
	motors[n] = 1;
	delay(50); // ESP32 may need to wait until the end of the current cycle to change duty https://github.com/espressif/arduino-esp32/issues/5306
	sendMotors();
	delay(3000);
	motors[n] = 0;
	sendMotors();
	Serial.println("Done");
}

void parseInput() {
	static bool showMotd = true;
	static String input;

	if (showMotd) {
		Serial.println(motd);
		showMotd = false;
	}

	while (Serial.available()) {
		char c = Serial.read();
		if (c == '\n') {
			char chars[input.length() + 1];
			input.toCharArray(chars, input.length() + 1);
			String command = stringToken(chars, " ");
			String arg0 = stringToken(NULL, " ");
			String arg1 = stringToken(NULL, "");
			doCommand(command, arg0, arg1);
			input.clear();
		} else {
			input += c;
		}
	}
}

// Helper function for parsing input
String stringToken(char* str, const char* delim) {
	char* token = strtok(str, delim);
	return token == NULL ? "" : token;
}
