sleeperov/shmel-ok/shmel-ok/wifi.ino

// Wi-Fi support

#if WIFI_ENABLED

#include <WiFi.h>
#include <WiFiAP.h>
#include <WiFiUdp.h>

#define WIFI_SSID "shmel-ok"
#define WIFI_PASSWORD "shmel-ok"
#define WIFI_UDP_IP "255.255.255.255"
#define WIFI_UDP_PORT 14550

WiFiUDP udp;

void setupWiFi() {
	Serial.println("Setup Wi-Fi");
	WiFi.softAP(WIFI_SSID, WIFI_PASSWORD);
	udp.begin(WIFI_UDP_PORT);
}

void sendWiFi(const uint8_t *buf, int len) {
	udp.beginPacket(WIFI_UDP_IP, WIFI_UDP_PORT);
	udp.write(buf, len);
	udp.endPacket();
}

int receiveWiFi(uint8_t *buf, int len) {
	udp.parsePacket();
	return udp.read(buf, len);
}

#endif
